MatthewClar-k/Self-Balancing-Robot/README.md

# Self-Balancing-Robot
My attempt at building a custom self-balancing robot.
