MatthewClar-k/Self-Balancing-Robot/Self Balancing Robot v2.docx

Self-Balancing Robot (Inverted Pendulum on Wheels)

IDEA

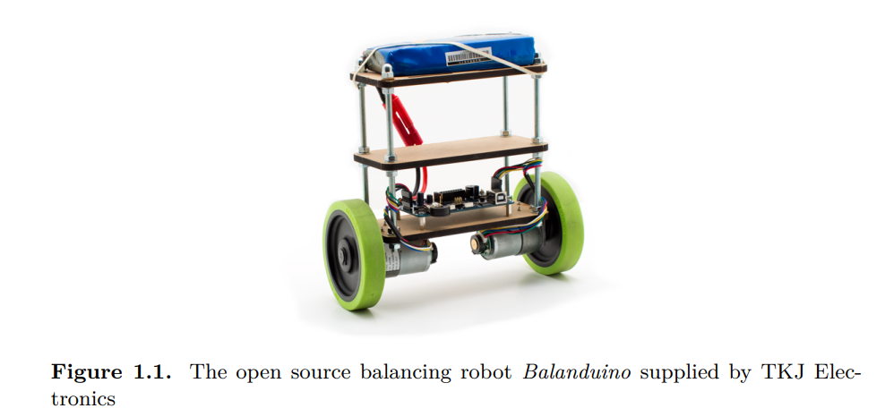
[picture p1: figure]

How it works

1. An IMU sensor (accelerometer + gyroscope) measures the robot’s tilt angle
2. A Kalman filter (or complementary filter) fuses the sensor data for a clean angle estimate
3. A PID controller computes motor corrections in real time to keep it balanced
4. Two DC motors with encoders drive the wheels accordingly
5. (Optional) Full LQR state-space controller

Suggested Stack

Component | Suggested Part | Approximate Cost
Microcontroller | Arduino | R80 – R150
IMU | MPU-6050 (6-axis) | R60 - R100
Motor Driver | L298N Dual H-Bridge | R60 - R90
DC Gear Motors (x2) | With encoders, 6V-12V | R200 – R400
Wheels (x2) | 65 mm rubber wheels | R60 – R120
Chassis | Laser-cut acrylic or 3D printed | R150 – R300
Battery | 2S LiPo or 4x AA pack | R100 – R200
Misc. (wiring, standoffs, switches) | --- | R100 – R150
Total | | ~R810 – R1510

Leaving room to add Raspberry Pi for data logging, a Bluetooth module for tuning PID gains wirelessly, or even an LCD to display live sensor values.

Where to buy

- Micro Robotics (https://www.robotics.org.za/) (Stellenbosch)
- Communica (https://www.communica.co.za/) (Paarden Eiland)
- RS Components SA (https://za.rs-online.com/) (Online)
- DigiKey South Africa (https://www.digikey.co.za/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) (Online)

Milestones

1. Get the IMU reading – wire up the MPU-6050, read raw data, implement a complementary filter to get a clean tilt angle.
2. Drive the motors – test the H-bridge, get basic forward/back working
3. Close the loop – implement a basic P controller first, observe instability, then add I and D terms
4. Tune the PID – this is where the fun (and frustration!) is
5. Stretch goal – implement an LQR controller and compare performance to PID

External Links

- https://www.instructables.com/Self-Balancing-Upside-Down-Pendulum/
- https://www.shaysackett.com/inverted-pendulum-robot/
- https://www.diva-portal.org/smash/get/diva2:916184/FULLTEXT01.pdf
- https://youtu.be/jP7Y_BfuGDI?si=Myiii08xSY3t1dM1 - Balancing robot tips video.

Objectives

1. Get it to balance “horizontally”.
2. Get it to balance “vertically”.
3. Implement cascaded PID loop (velocity = 0).
4. Try to implement LQR?

VERSION HISTORY

Idea is to do a prototype with version 2 and then upgrade the motors to version 3.

Version | Description of Change
v1 | First draft
V2 | Changed motor to one that has encoder which will allow cascaded PID loops

VERSION 2

COMPONENTS

Motor (with encoder)

- First try a software solution with v1 motors.
- If that does not work: https://www.digikey.co.za/en/products/detail/dfrobot/FIT0450/7597205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. This is the same shaped motor as v1, which is very convenient.
- If that doesn’t work, upgraded motor:

SCHEMATIC / CONNECTION DIAGRAM

- Table and diagrams here to track how many pins I need / what is connected to what.

Component | Connects To

DRV8833
EEP | ---
Out 1 | Motor A (through encoder)
Out 2 | Motor A (through encoder)
Out 3 | Motor B (through encoder)
Out 4 | Motor B (through encoder)
ULT | ---
IN 4 | Arduino Digital Output Pin
IN 3 | Arduino Digital Output Pin
GND | Battery- and Arduino GND
VCC | Battery+
IN2 | Arduino Digital Output Pin
IN1 | Arduino Digital Output Pin

Motor Encoder
GND | Arduino GND
OUT B | Arduino Input Pin
OUT A | Arduino Input Pin
VCC | Arduino Digital Output Pin
M2 | Motor+
M1 | Motor-

Arduino Uno has 14 digital output pins (labelled 0 to 13). This should be plenty (currently using 7).

VOLTAGE & CURRENT ANALYSIS

Device | Voltage

Motors, Drivers & Encoders
Motor Driver Input | 2.7 V to 10.8 V
DC Motors | 6 V
Motor Driver Output | 7.4 V – 0.12 V = 7.28 V (must use PWM)
Encoder Input | 2.7 V to 18 V

** Motors will see roughly 7.28 V. Must drive DRV8833 with PWM signal so that it receives approximately 6 V. Measure with multimeter!

Current

Device | Current
DC Motors @6V no-load | 70 mA
Driver Continuous Current Limit | 1.2 A (per motor)
DC Motors @6V when stalled | 1.6 A
Driver Peak Current Limit | 2 A (per motor)
MPU6050 Current Draw | 3.9 mA to 5.1 mA
Arduino Uno 5V Pin Current Limit | 800 mA
Arduino Digital I/O Pins | 20 mA (40 mA absolute max)
10k Potentiometer | 0.5 mA

** Peak motor driver current is not exceeded. MPU6050 and Potentiometers can be powered from standard Arduino Digital Output pin.

BILL OF MATERIALS

Component | Price | Quantity | Total | Link
Motor with encoder | R | 1 | R | Microrobotics (https://www.robotics.org.za/index.php?product_id=1015&route=product/product)
Total | | | R

SOFTWARE

Control Algorithm

- Two nested PID loops. Inner loop drives position to 0 degrees, outer loop drives motor velocity to 0 m/s.

Notes

- W

QUESTIONS

1. Ask Claude if my planned set up will work – Only potential issue is RPM range of current motors (200 rpm). Most successful projects use higher speed motors (e.g. 300 to 500 rpm range). Shouldn’t be impossible but will make PID tunning more difficult (Tips and tricks video uses this motor).
2. For a balancing robot you're running an MPU6050 over I2C, two encoder ISRs, and two nested PID loops all simultaneously. The Uno's 8-bit 16MHz processor and 2KB of RAM get tight quickly. Many people building this exact project switch to an ESP32, which has interrupts on every GPIO pin, runs at 240MHz, has two cores, and costs about the same. Worth considering before you get too deep into the Uno build. Guy in article used MEGA which isn’t any faster – so don’t think this will be a problem. But can just see how it goes.
