MatthewClar-k/Self-Balancing-Robot/(commit log)

2026-08-06 Create DC Motor.pdf
2026-08-06 Create N20 Motor.pdf
2026-08-06 Create Two-Wheeled Self-Balancing Robot (Bachelor’s Thesis).pdf
2026-08-17 Update 0_mpu6050_calibration.ino
    Replace CalibrateAccel/Gyro with six-pose calibration
    The library's CalibrateAccel() drives the Z accel reading toward +1g,
    which assumes the chip is mounted flat and Z-up. The MPU6050 here is
    glued to the Arduino in an inverted orientation, so that assumption
    fails and the routine produced offsets wrong by roughly 2g on Z.
    Symptom was an angle that looked plausible at rest and became nonsense
    under motion.
    Characterisation over six orientations found a second, unrelated fault:
    sensor X carries a permanent ~+2g zero-g bias and saturates against the
    int16 rail at +/-2g full scale. Confirmed as a real sensor property
    rather than a bus or scaling error - X rea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
    [0_mpu6050_calibration.ino]
2026-08-17 Delete 1_mpu6050_raw_values.ino
    Remove DMP-based orientation code
    Unusable on this unit: the DMP fuses all three axes, and sensor X
    rails at +/-2g. Replaced by a complementary filter on accel Y/Z
    plus gyro X.
2026-08-17 Delete 3_mpu6050_angles_v2.ino
    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
2026-08-17 Delete 2_mpu6050_angles.ino
    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
2026-08-17 Create 1_mpu6050_angles.ino
    Remove DMP-based orientation code, superseded by complementary filter
2026-08-19 Update main.ino
    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
